K4zuki/gpak-7seg-clock/README.md

# gpak-7seg-clock
7-seg LED clock application using GreenPAK
