K4zuki/gpak-7seg-clock/docs/images/config1-overview.png

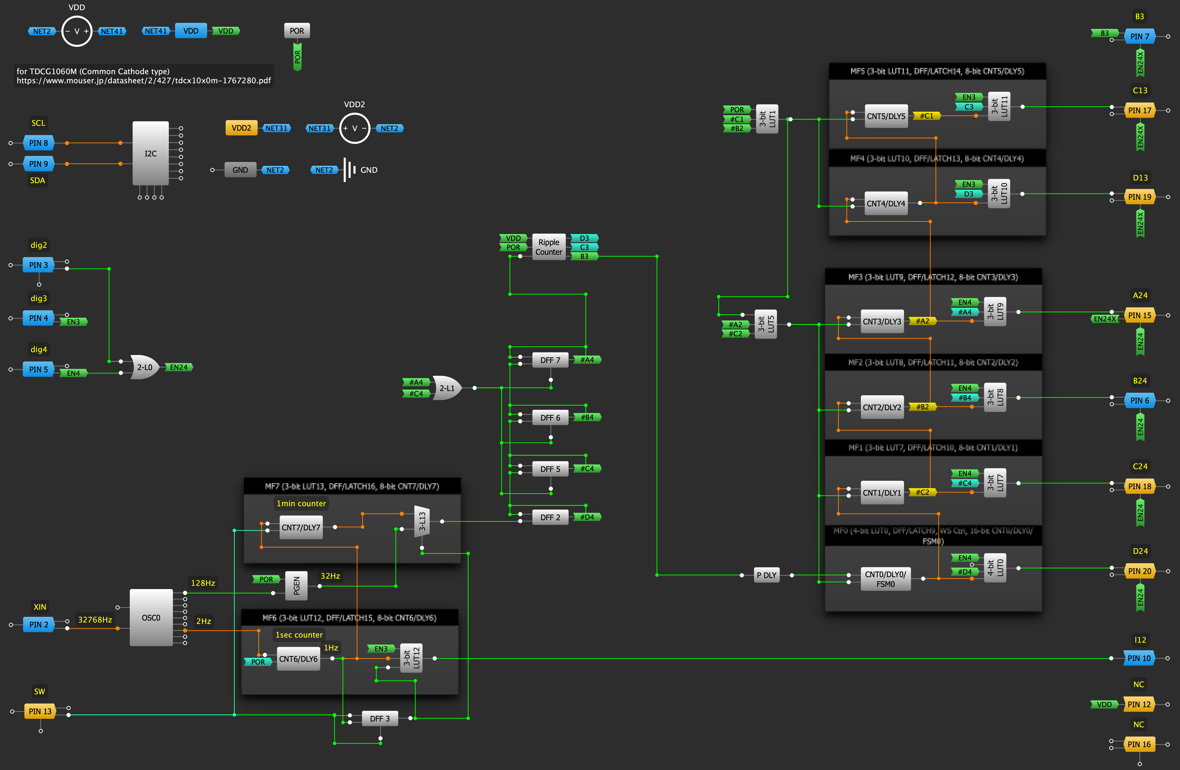
docs/images/config1-overview.png
