K4zuki/gpak-7seg-clock/docs/images/digit-timing-generator.png

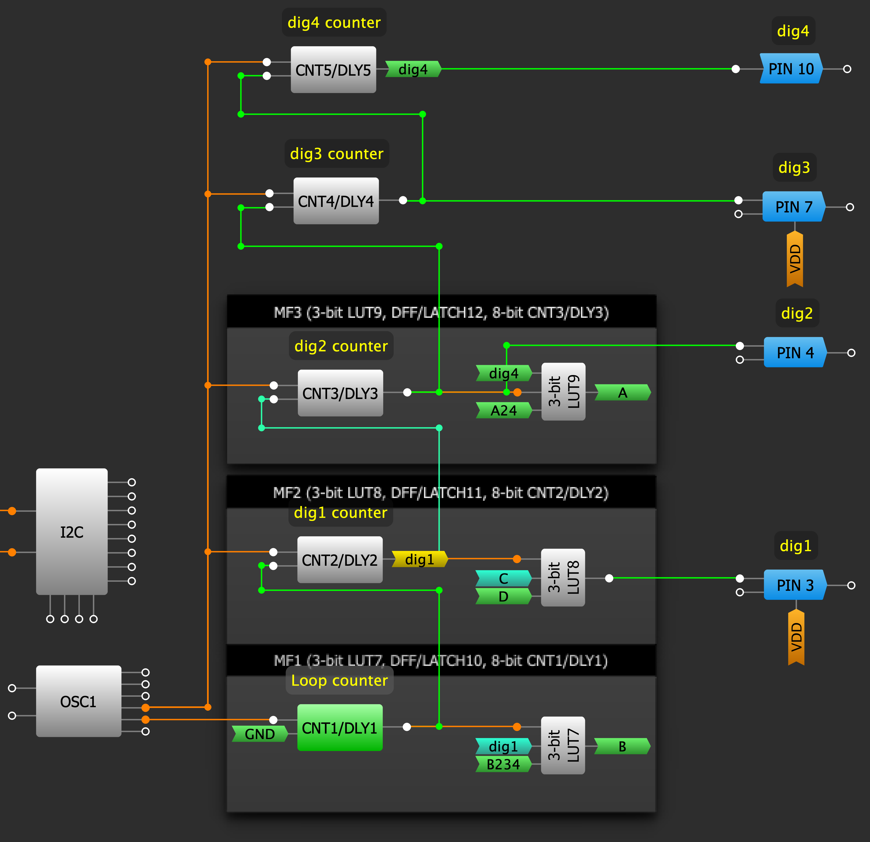
docs/images/digit-timing-generator.png
