K4zuki/gpak-7seg-clock/docs/images/time-division-mux.png

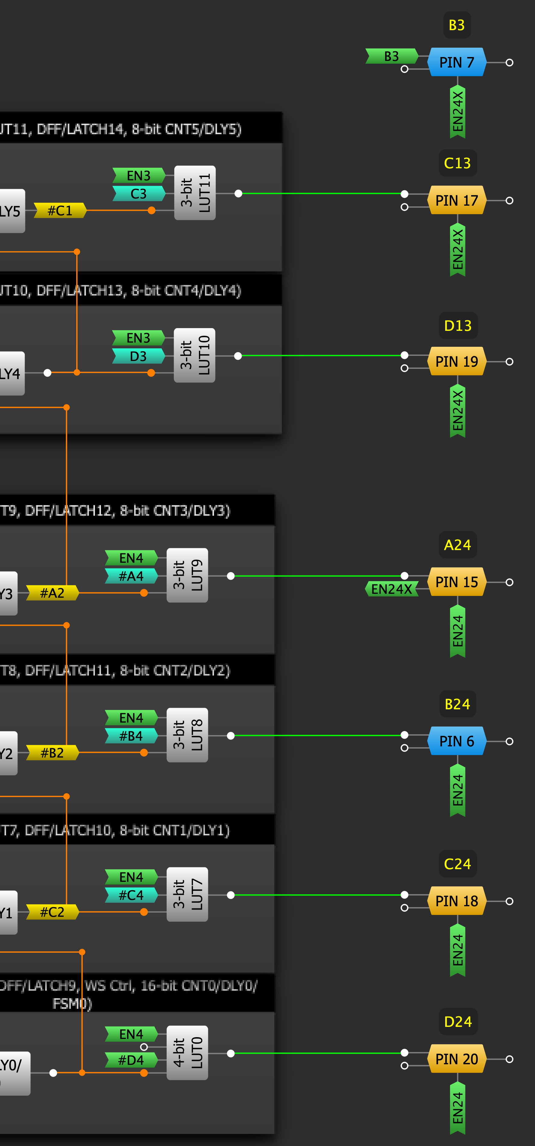
docs/images/time-division-mux.png
