K4zuki/gpak-7seg-clock/536-counter-7seg/4-digit-clock.brd

## EAGLE design 536-counter-7seg/4-digit-clock.brd (2022-05-12)

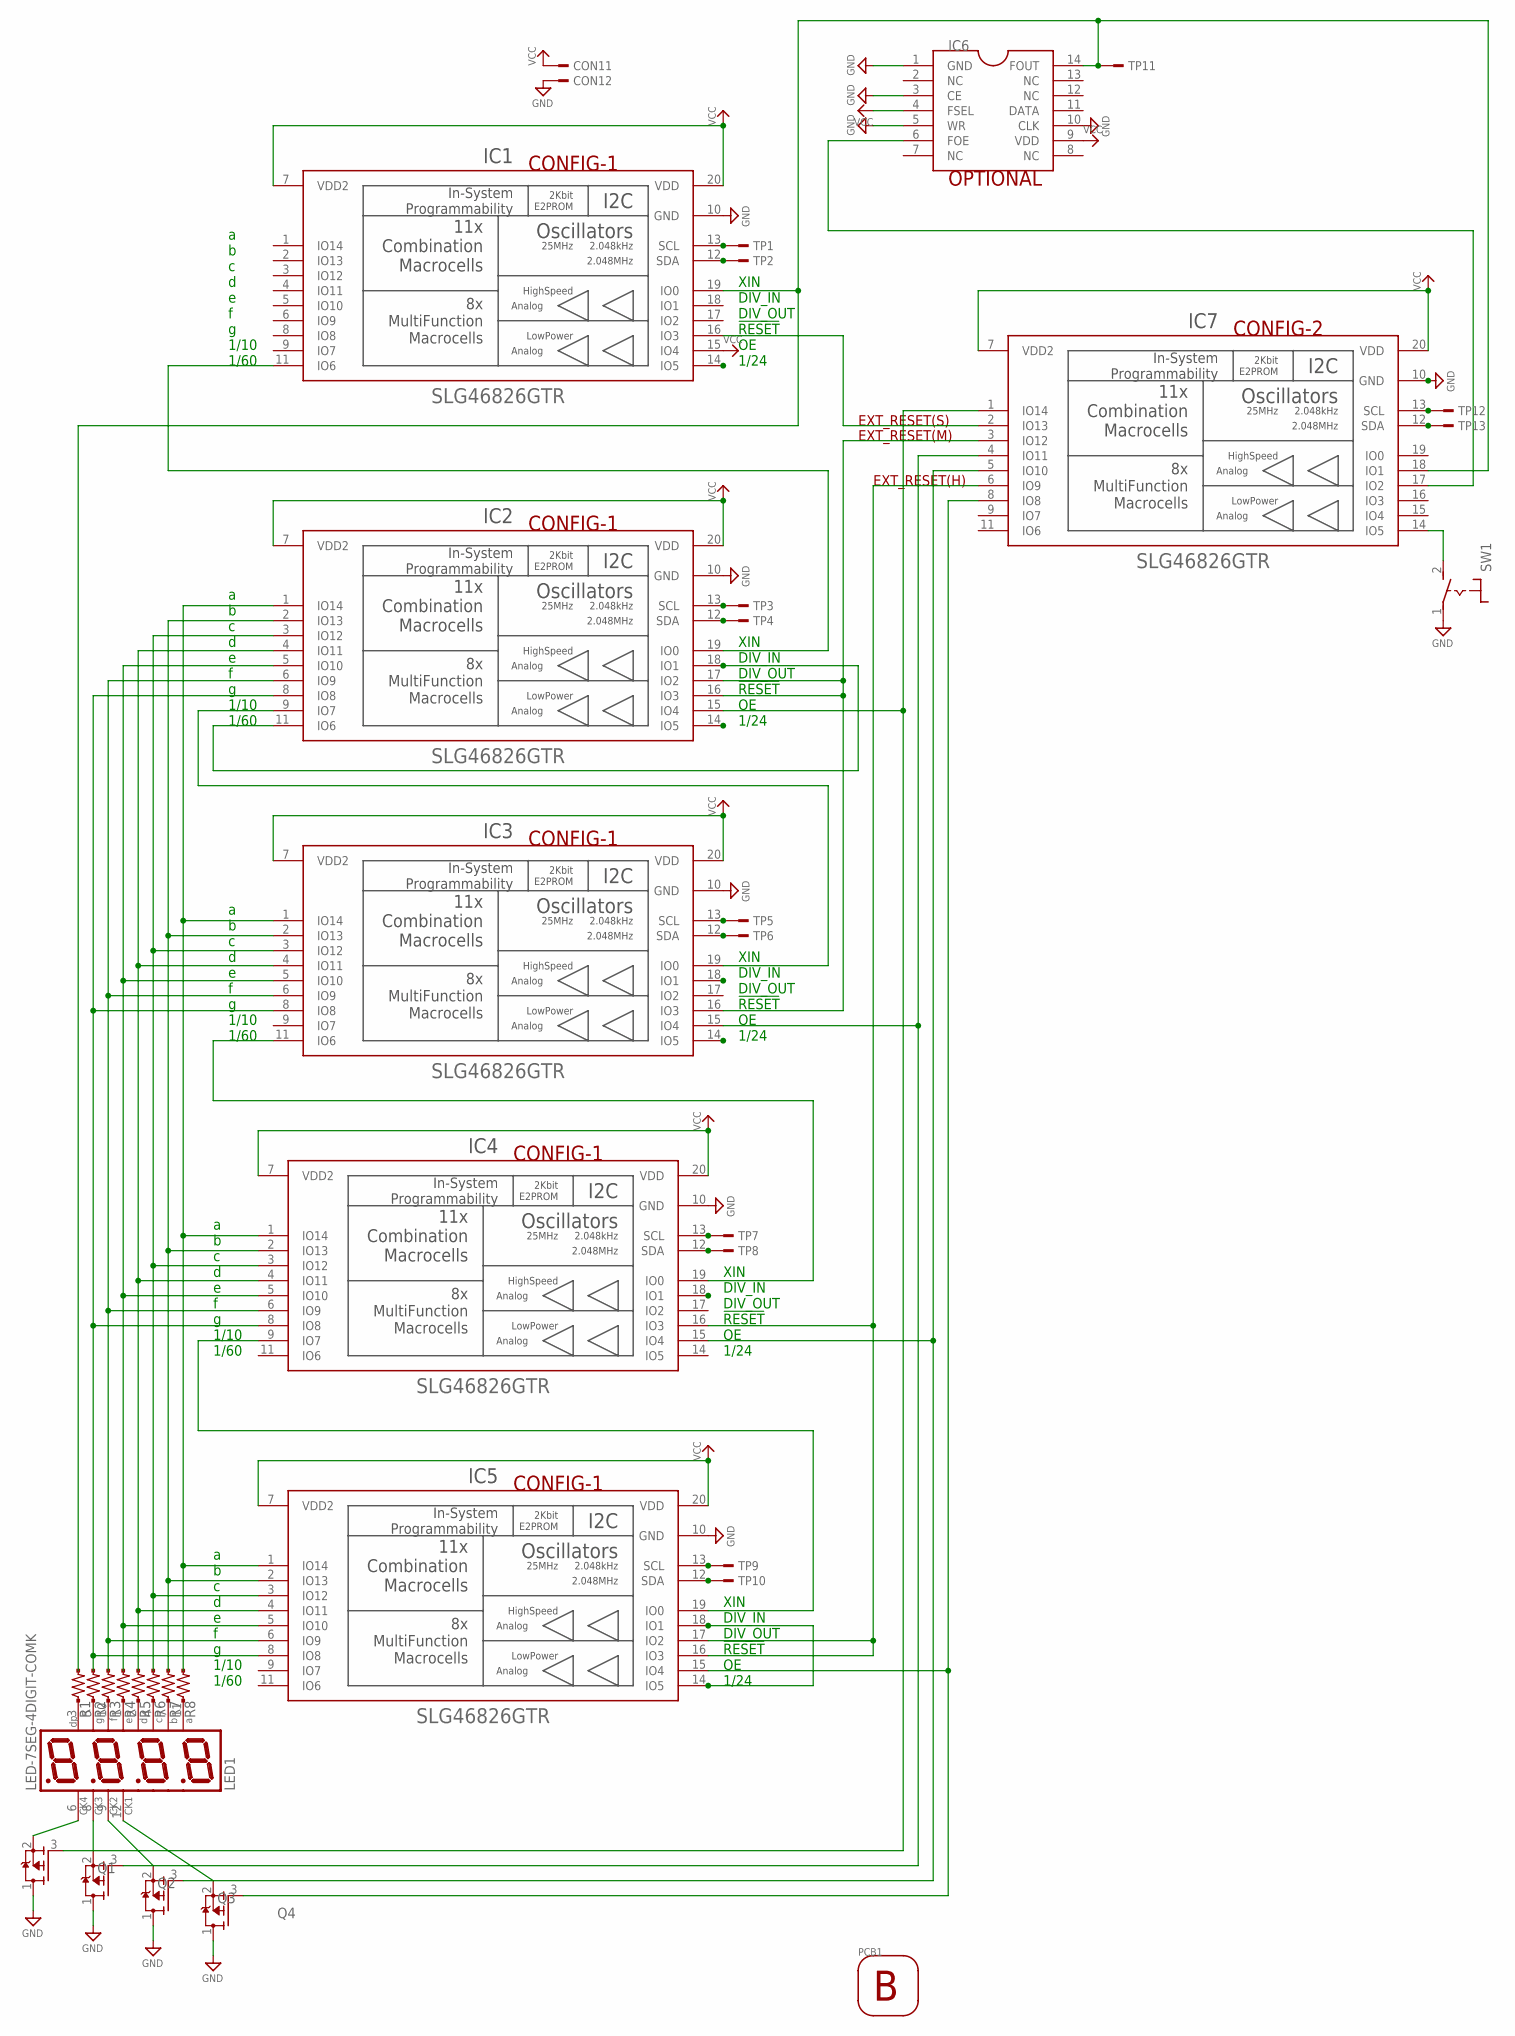
[picture p13: schematic 4-digit-clock.sch]

Parts:
CON1: B2B-XH-A; B2B-XH-A(LF)(SN)
IC1, IC2, IC3, IC4, IC5, IC7: SLG46826GTR; SOT65P650X440-20N
IC6: RTC-4543SA; SOT127P1010X500-14N
LED1: LED-7SEG-4DIGIT-COMK; LED-7SEG-4DIGIT
PCB1: P-MCS78A
Q1, Q2, Q3, Q4: 2N7002; SOT95P300X140-3N
R1, R2, R3, R4, R5, R6, R7, R8: R-US-1.0K-1005; C0402
SW1: TACTSW2-BK-TL1105S; SW-TACTSW-TL1105S
TP1, TP2, TP3, TP4, TP5, TP6, TP7, TP8, TP9, TP10, TP11, TP12, TP13: TESTPAD-1608; TP-1608

Connections:
GND: CON1.2, IC1.10 (GND), IC2.10 (GND), IC3.10 (GND), IC4.10 (GND), IC5.10 (GND), IC6.1 (GND), IC6.3 (CE), IC6.5 (WR), IC6.10 (CLK), IC7.10 (GND), Q1.1 (D), Q2.1 (D), Q3.1 (D), Q4.1 (D), SW1.1
unnamed: IC2.6 (IO9), IC3.6 (IO9), IC4.6 (IO9), IC5.6 (IO9), R3.2
unnamed: IC2.4 (IO11), IC3.4 (IO11), IC4.4 (IO11), IC5.4 (IO11), R5.2
unnamed: IC2.2 (IO13), IC3.2 (IO13), IC4.2 (IO13), IC5.2 (IO13), R7.2
unnamed: IC2.1 (IO14), IC3.1 (IO14), IC4.1 (IO14), IC5.1 (IO14), R8.2
unnamed: IC2.3 (IO12), IC3.3 (IO12), IC4.3 (IO12), IC5.3 (IO12), R6.2
unnamed: IC2.5 (IO10), IC3.5 (IO10), IC4.5 (IO10), IC5.5 (IO10), R4.2
unnamed: IC2.8 (IO8), IC3.8 (IO8), IC4.8 (IO8), IC5.8 (IO8), R2.2
unnamed: LED1.6 (CA4), Q1.2 (S)
unnamed: IC1.11 (IO6), IC2.19 (IO0)
unnamed: IC1.19 (IO0), IC6.14 (FOUT), IC7.18 (IO1), R1.2, TP11.TP
unnamed: IC2.11 (IO6), IC2.18 (IO1)
unnamed: LED1.8 (CA), Q2.2 (S)
unnamed: LED1.9 (CA), Q3.2 (S)
unnamed: LED1.12 (CA), Q4.2 (S)
unnamed: IC2.15 (IO4), IC7.1 (IO14), Q1.3 (G)
unnamed: IC3.15 (IO4), IC7.4 (IO11), Q2.3 (G)
unnamed: IC4.15 (IO4), IC7.5 (IO10), Q3.3 (G)
unnamed: IC2.9 (IO7), IC3.19 (IO0)
unnamed: IC5.15 (IO4), IC7.8 (IO8), Q4.3 (G)
unnamed: LED1.3 (DP), R1.1
unnamed: IC2.16 (IO3), IC2.17 (IO2), IC3.16 (IO3), IC7.3 (IO12)
unnamed: IC4.16 (IO3), IC5.16 (IO3), IC5.17 (IO2), IC7.6 (IO9)
unnamed: IC3.11 (IO6), IC4.19 (IO0)
unnamed: IC2.13 (SCL), TP3.TP
unnamed: IC2.12 (SDA), TP4.TP
unnamed: IC3.13 (SCL), TP5.TP
unnamed: IC3.12 (SDA), TP6.TP
unnamed: IC4.13 (SCL), TP7.TP
unnamed: IC4.12 (SDA), TP8.TP
unnamed: IC5.13 (SCL), TP9.TP
unnamed: IC5.14 (IO5), IC5.18 (IO1)
unnamed: LED1.5 (G), R2.1
unnamed: IC4.9 (IO7), IC5.19 (IO0)
unnamed: IC5.12 (SDA), TP10.TP
unnamed: LED1.10 (F), R3.1
unnamed: LED1.1 (E), R4.1
unnamed: LED1.2 (D), R5.1
unnamed: LED1.4 (C), R6.1
unnamed: LED1.7 (B), R7.1
unnamed: LED1.11 (A), R8.1
unnamed: IC7.13 (SCL), TP12.TP
unnamed: IC7.12 (SDA), TP13.TP
unnamed: IC7.14 (IO5), SW1.2 (S)
unnamed: IC6.6 (FOE), IC7.17 (IO2)
unnamed: IC1.16 (IO3), IC7.2 (IO13)
unnamed: IC1.13 (SCL), TP1.TP
unnamed: IC1.12 (SDA), TP2.TP
VCC: CON1.1, IC1.7 (VDD2), IC1.15 (IO4), IC1.20 (VDD), IC2.7 (VDD2), IC2.20 (VDD), IC3.7 (VDD2), IC3.20 (VDD), IC4.7 (VDD2), IC4.20 (VDD), IC5.7 (VDD2), IC5.20 (VDD), IC6.4 (FSEL), IC6.9 (VDD), IC7.7 (VDD2), IC7.20 (VDD)

Notes on the sheet:
XIN DIV_IN DIV_OUT !RESET! OE 1/24
a b c d e f g 1/10 1/60
CONFIG-1
CONFIG-2
OPTIONAL
EXT_RESET(S)
EXT_RESET(M)
EXT_RESET(H)

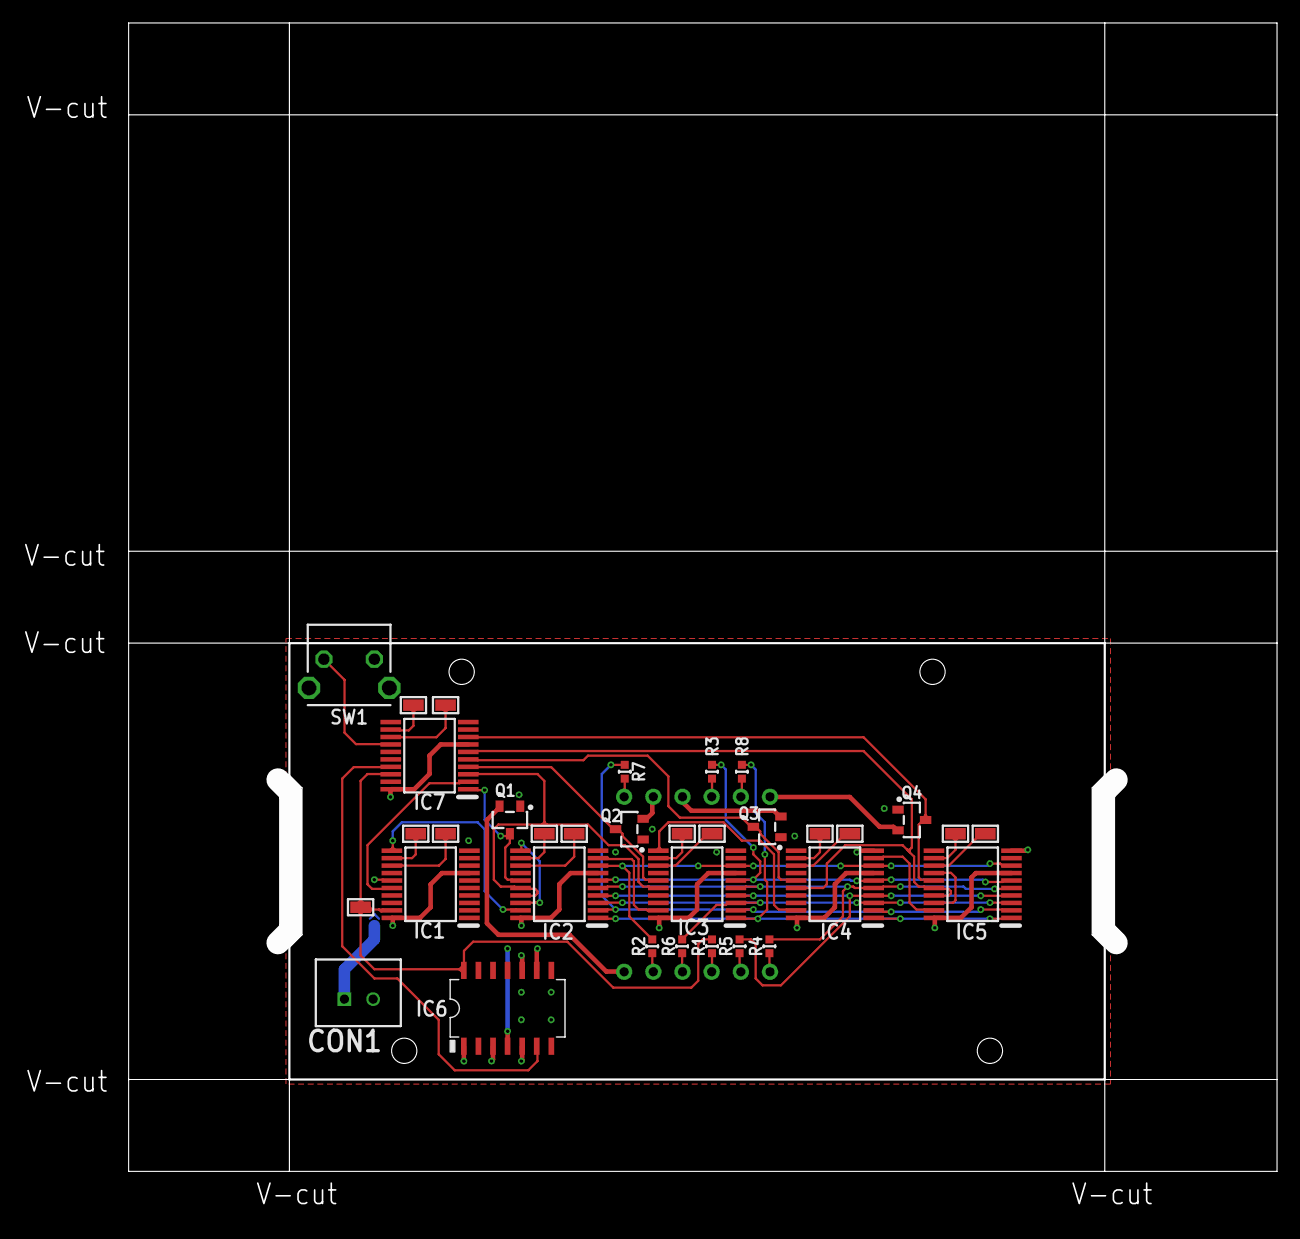
[picture p14: board 4-digit-clock.brd from above]

Board: 2 copper layers, 100.0 x 100.0 mm, 36 parts (1 on the bottom side), 49 nets.
