K4zuki/gpak-7seg-clock/536-counter-7seg/536-counter-7seg-P.brd

## EAGLE design 536-counter-7seg/536-counter-7seg-P.brd (2019-08-14)

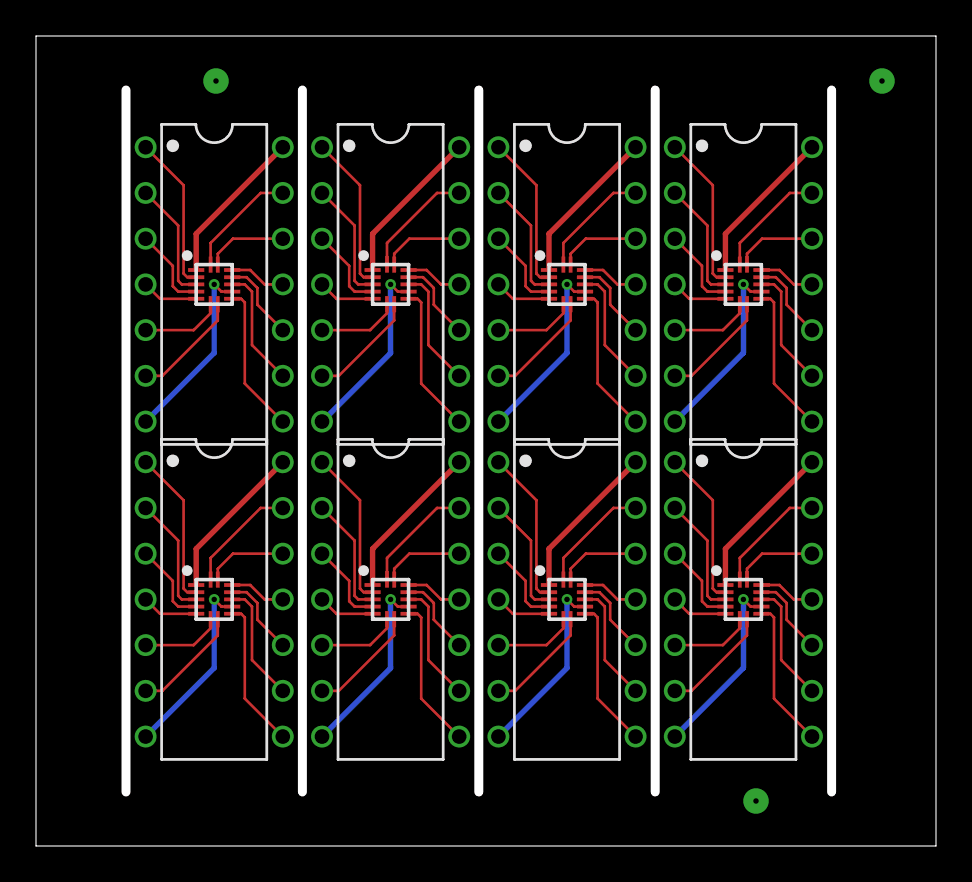
[picture p15: board 536-counter-7seg-P.brd from above]

Board: 2 copper layers, 50.0 x 45.0 mm, 16 parts (0 on the bottom side), 112 nets.

Parts:
IC1, IC3, IC5, IC7, IC9, IC11, IC13, IC15: STQFN14-0.4P2.0X2.2
IC2, IC4, IC6, IC8, IC10, IC12, IC14, IC16: IC-TTL-74-04,14-DIP; IC-SOCKET-DIL-14

Connections:
GND: IC1.9, IC2.7
GND1: IC3.9, IC4.7
GND2: IC5.9, IC6.7
GND3: IC7.9, IC8.7
GND4: IC9.9, IC10.7
GND5: IC11.9, IC12.7
GND6: IC13.9, IC14.7
GND7: IC15.9, IC16.7
unnamed: IC1.1, IC2.14
unnamed: IC1.2, IC2.1
unnamed: IC1.3, IC2.2
unnamed: IC1.4, IC2.3
unnamed: IC1.5, IC2.4
unnamed: IC1.6, IC2.5
unnamed: IC1.7, IC2.6
unnamed: IC1.8, IC2.8
unnamed: IC1.10, IC2.9
unnamed: IC1.11, IC2.10
unnamed: IC1.12, IC2.11
unnamed: IC1.13, IC2.12
unnamed: IC1.14, IC2.13
unnamed: IC3.1, IC4.14
unnamed: IC3.2, IC4.1
unnamed: IC3.3, IC4.2
unnamed: IC3.4, IC4.3
unnamed: IC3.5, IC4.4
unnamed: IC3.6, IC4.5
unnamed: IC3.7, IC4.6
unnamed: IC3.8, IC4.8
unnamed: IC3.10, IC4.9
unnamed: IC3.11, IC4.10
unnamed: IC3.12, IC4.11
unnamed: IC3.13, IC4.12
unnamed: IC3.14, IC4.13
unnamed: IC5.1, IC6.14
unnamed: IC5.2, IC6.1
unnamed: IC5.3, IC6.2
unnamed: IC5.4, IC6.3
unnamed: IC5.5, IC6.4
unnamed: IC5.6, IC6.5
unnamed: IC5.7, IC6.6
unnamed: IC5.8, IC6.8
unnamed: IC5.10, IC6.9
unnamed: IC5.11, IC6.10
unnamed: IC5.12, IC6.11
unnamed: IC5.13, IC6.12
unnamed: IC5.14, IC6.13
unnamed: IC7.1, IC8.14
unnamed: IC7.2, IC8.1
unnamed: IC7.3, IC8.2
unnamed: IC7.4, IC8.3
unnamed: IC7.5, IC8.4
unnamed: IC7.6, IC8.5
unnamed: IC7.7, IC8.6
unnamed: IC7.8, IC8.8
unnamed: IC7.10, IC8.9
unnamed: IC7.11, IC8.10
unnamed: IC7.12, IC8.11
unnamed: IC7.13, IC8.12
unnamed: IC7.14, IC8.13
unnamed: IC9.1, IC10.14
unnamed: IC9.2, IC10.1
unnamed: IC9.3, IC10.2
unnamed: IC9.4, IC10.3
unnamed: IC9.5, IC10.4
unnamed: IC9.6, IC10.5
unnamed: IC9.7, IC10.6
unnamed: IC9.8, IC10.8
unnamed: IC9.10, IC10.9
unnamed: IC9.11, IC10.10
unnamed: IC9.12, IC10.11
unnamed: IC9.13, IC10.12
unnamed: IC9.14, IC10.13
unnamed: IC11.1, IC12.14
unnamed: IC11.2, IC12.1
unnamed: IC11.3, IC12.2
unnamed: IC11.4, IC12.3
unnamed: IC11.5, IC12.4
unnamed: IC11.6, IC12.5
unnamed: IC11.7, IC12.6
unnamed: IC11.8, IC12.8
unnamed: IC11.10, IC12.9
unnamed: IC11.11, IC12.10
unnamed: IC11.12, IC12.11
unnamed: IC11.13, IC12.12
unnamed: IC11.14, IC12.13
unnamed: IC13.1, IC14.14
unnamed: IC13.2, IC14.1
unnamed: IC13.3, IC14.2
unnamed: IC13.4, IC14.3
unnamed: IC13.5, IC14.4
unnamed: IC13.6, IC14.5
unnamed: IC13.7, IC14.6
unnamed: IC13.8, IC14.8
unnamed: IC13.10, IC14.9
unnamed: IC13.11, IC14.10
unnamed: IC13.12, IC14.11
unnamed: IC13.13, IC14.12
unnamed: IC13.14, IC14.13
unnamed: IC15.1, IC16.14
unnamed: IC15.2, IC16.1
unnamed: IC15.3, IC16.2
unnamed: IC15.4, IC16.3
unnamed: IC15.5, IC16.4
unnamed: IC15.6, IC16.5
unnamed: IC15.7, IC16.6
unnamed: IC15.8, IC16.8
unnamed: IC15.10, IC16.9
unnamed: IC15.11, IC16.10
unnamed: IC15.12, IC16.11
unnamed: IC15.13, IC16.12
unnamed: IC15.14, IC16.13
