K4zuki/gpak-7seg-clock/(commit log)

2019-08-14 add board files
    [536-counter-7seg-P.brd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]
2019-08-17 initial inputs
    [truth-table.csv]
2020-04-11 update schematics
    - bcd-counter-7seg.gp6 = 46826 segment decoder/counter
    - ring-shifter.gp6 = 46826 digit shifter/switch interface
    - 536-* = for 46536 although target schematic does not fit
2020-04-11 add 4-digit clock application schematic and board layout
    [4-digit-clock.brd, 4-digit-clock.sch]
2020-04-28 update pcb layouts
    [4-digit-clock.brd, 4-digit-clock.sch]
2020-05-02 update gp6 schematics
2020-05-03 update GP6 schematic
2021-01-04 update truth-table.csv - add decimal number column
    [truth-table.csv]
2022-05-12 update Dockerfile - drop tlmgr update for now
    [4-digit-clock.brd]
